settinger/12bitbadge/12bitbadge.kicad_pcb

## KiCad design 12bitbadge.kicad_pcb (2020-03-08)

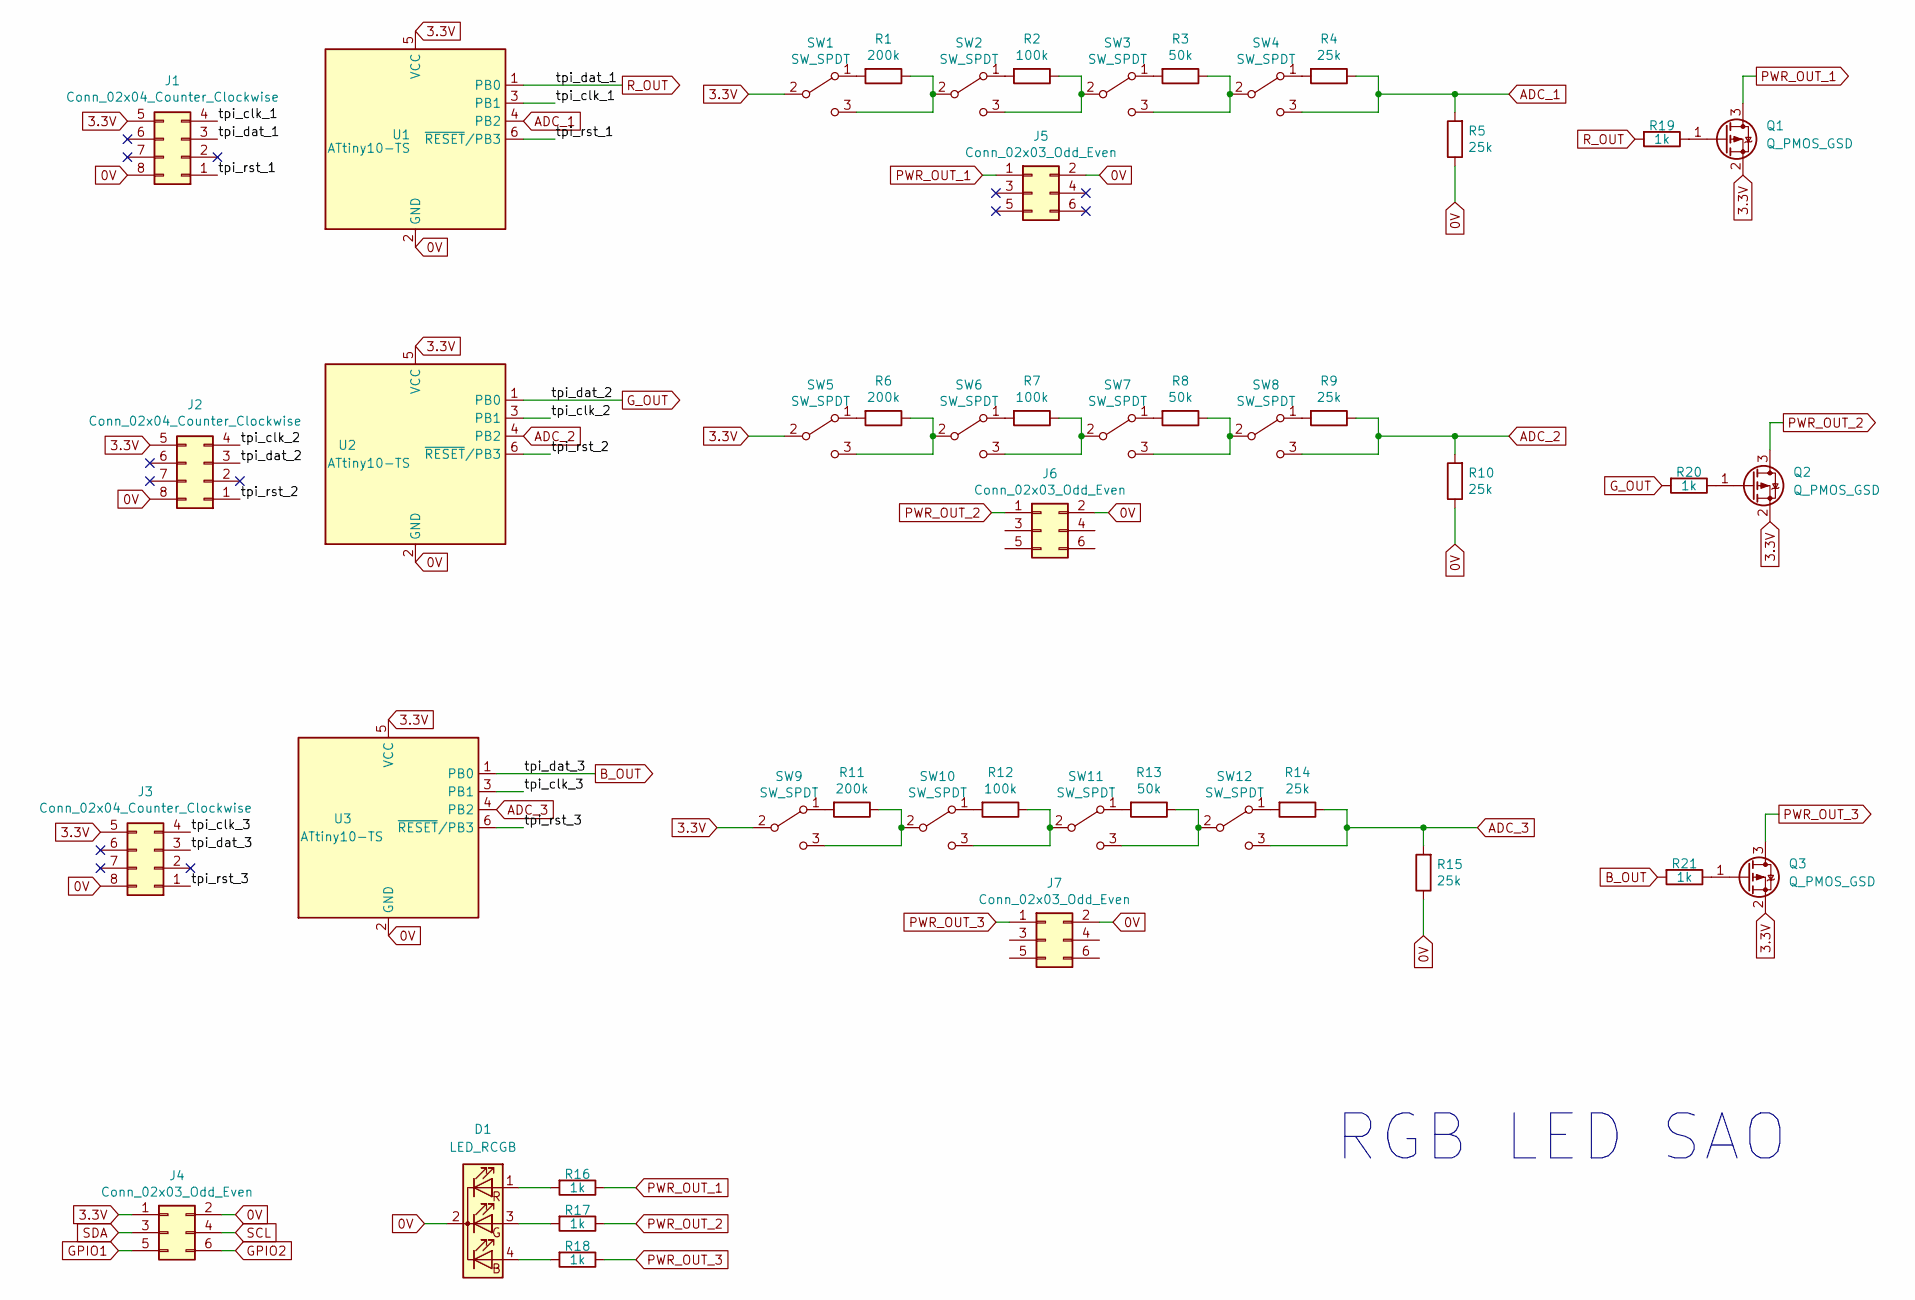
[picture p1: schematic 12bitbadge.sch]

Parts:
D1: LED_RCGB; LED_D5.0mm-4_RGB
J1, J2, J3: Conn_02x04_Counter_Clockwise; SOIC_clipProgSmall
J4: Conn_02x03_Odd_Even; PinHeader_2x03_P2.54mm_Vertical
J5, J6, J7: Conn_02x03_Odd_Even; PinSocket_2x03_P2.54mm_Vertical
Q1, Q2, Q3: Q_PMOS_GSD; SOT-23_Handsoldering
R1, R6, R11: 200k; R_0805_2012Metric_Pad1.15x1.40mm_HandSolder
R2, R7, R12: 100k; R_0805_2012Metric_Pad1.15x1.40mm_HandSolder
R3, R8, R13: 50k; R_0805_2012Metric_Pad1.15x1.40mm_HandSolder
R4, R5, R9, R10, R14, R15: 25k; R_0805_2012Metric_Pad1.15x1.40mm_HandSolder
R16, R17, R18, R19, R20, R21: 1k; R_0805_2012Metric_Pad1.15x1.40mm_HandSolder
SW1, SW2, SW3, SW4, SW5, SW6, SW7, SW8, SW9, SW10, SW11, SW12: SW_SPDT; SW_CuK_JS202011CQN_DPDT_Straight
U1, U2, U3: ATtiny10-TS; SOT-23-6_Handsoldering

Connections:
0V: D1.2 (K), J1.8, J2.8, J3.8, J4.2, J5.2, J6.2, J7.2, R5.1, R10.1, R15.1, U1.2 (GND), U2.2 (GND), U3.2 (GND)
3.3V: J1.5, J2.5, J3.5, J4.1, Q1.2 (S), Q2.2 (S), Q3.2 (S), SW1.2 (B), SW5.2 (B), SW9.2 (B), U1.5 (VCC), U2.5 (VCC), U3.5 (VCC)
/tpi_clk_1: J1.4, U1.3 (PB1)
/tpi_clk_2: J2.4, U2.3 (PB1)
/tpi_clk_3: J3.4, U3.3 (PB1)
/tpi_rst_1: J1.1, U1.6 (~RESET~/PB3)
/tpi_rst_2: J2.1, U2.6 (~RESET~/PB3)
/tpi_rst_3: J3.1, U3.6 (~RESET~/PB3)
ADC_1: R4.1, R5.2, SW4.3 (C), U1.4 (PB2)
ADC_2: R9.1, R10.2, SW8.3 (C), U2.4 (PB2)
ADC_3: R14.1, R15.2, SW12.3 (C), U3.4 (PB2)
B_OUT: J3.3, R21.2, U3.1 (PB0)
GPIO1: J4.5
GPIO2: J4.6
G_OUT: J2.3, R20.2, U2.1 (PB0)
unnamed: D1.1 (RA), R16.2
unnamed: D1.3 (GA), R17.2
unnamed: D1.4 (BA), R18.2
unnamed: Q1.1 (G), R19.1
unnamed: Q2.1 (G), R20.1
unnamed: Q3.1 (G), R21.1
unnamed: R1.1, SW1.3 (C), SW2.2 (B)
unnamed: R1.2, SW1.1 (A)
unnamed: R2.1, SW2.3 (C), SW3.2 (B)
unnamed: R2.2, SW2.1 (A)
unnamed: R3.1, SW3.3 (C), SW4.2 (B)
unnamed: R3.2, SW3.1 (A)
unnamed: R4.2, SW4.1 (A)
unnamed: R6.1, SW5.3 (C), SW6.2 (B)
unnamed: R6.2, SW5.1 (A)
unnamed: R7.1, SW6.3 (C), SW7.2 (B)
unnamed: R7.2, SW6.1 (A)
unnamed: R8.1, SW7.3 (C), SW8.2 (B)
unnamed: R8.2, SW7.1 (A)
unnamed: R9.2, SW8.1 (A)
unnamed: R11.1, SW9.3 (C), SW10.2 (B)
unnamed: R11.2, SW9.1 (A)
unnamed: R12.1, SW10.3 (C), SW11.2 (B)
unnamed: R12.2, SW10.1 (A)
unnamed: R13.1, SW11.3 (C), SW12.2 (B)
unnamed: R13.2, SW11.1 (A)
unnamed: R14.2, SW12.1 (A)
PWR_OUT_1: J5.1, Q1.3 (D), R16.1
PWR_OUT_2: J6.1, Q2.3 (D), R17.1
PWR_OUT_3: J7.1, Q3.3 (D), R18.1
R_OUT: J1.3, R19.2, U1.1 (PB0)
SCL: J4.4
SDA: J4.3

Notes on the sheet:
RGB LED SAO

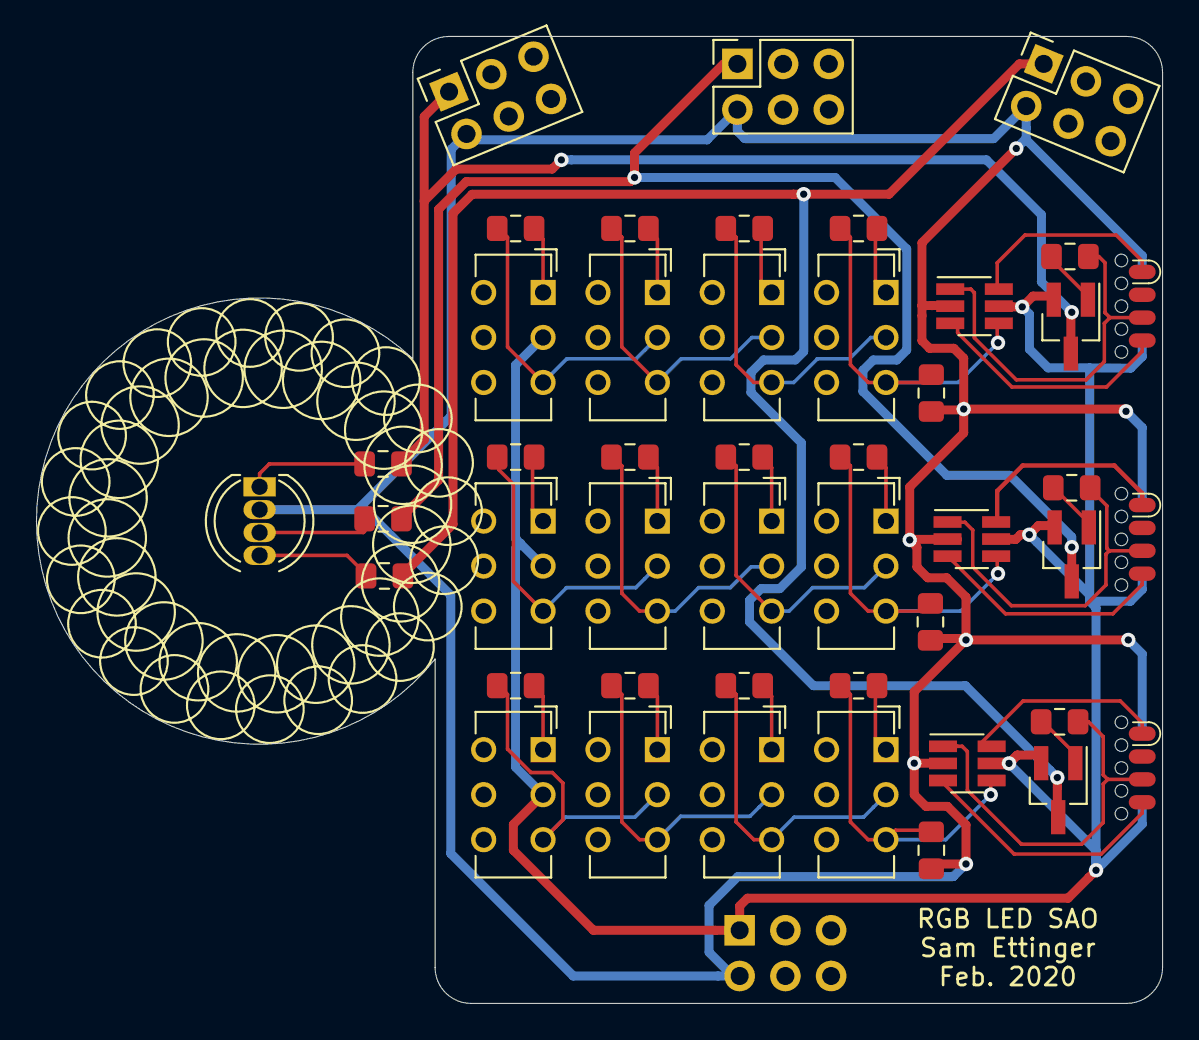
[picture p2: board 12bitbadge.kicad_pcb from above]

Board: 2 copper layers, 62.6 x 53.7 mm, 47 parts (1 on the bottom side), 44 nets.
