settinger/12bitbadge/(commit log)

2020-01-23 Initialized project
    [12bitbadge.kicad_pcb, 12bitbadge.sch]
2020-01-23 Small routing tweaks
    [12bitbadge.kicad_pcb]
2020-01-23 Removed errant trace above sheet
    [12bitbadge.kicad_pcb]
2020-01-23 Put the add-on add-onsat a more rakish angle
    [12bitbadge.kicad_pcb]
2020-01-23 Added gerbers
    [12bitbadge-B_Cu.gbr, 12bitbadge-B_Mask.gbr, 12bitbadge-B_Paste.gbr, 12bitbadge-B_SilkS.gbr, 12bitbadge-Edge_Cuts.gbr, 12bitbadge-F_Cu.gbr, 12bitbadge-F_Mask.gbr, 12bitbadge-F_Paste.gbr]
2020-01-25 Updated to hand-solderable SMD
    [12bitbadge-B_Cu.gbr, 12bitbadge-B_Mask.gbr, 12bitbadge-B_Paste.gbr, 12bitbadge-B_SilkS.gbr, 12bitbadge-Edge_Cuts.gbr, 12bitbadge-F_Cu.gbr, 12bitbadge-F_Mask.gbr, 12bitbadge-F_Paste.gbr]
2020-01-25 Added silkscreen rosettes
    [12bitbadge-B_Cu.gbr, 12bitbadge-B_Mask.gbr, 12bitbadge-B_Paste.gbr, 12bitbadge-B_SilkS.gbr, 12bitbadge-Edge_Cuts.gbr, 12bitbadge-F_Cu.gbr, 12bitbadge-F_Mask.gbr, 12bitbadge-F_Paste.gbr]
2020-01-26 Replaced switches with PWM-friendly MOSFETs
    [12bitbadge-B_Cu.gbr, 12bitbadge-B_Mask.gbr, 12bitbadge-B_Paste.gbr, 12bitbadge-B_SilkS.gbr, 12bitbadge-Edge_Cuts.gbr, 12bitbadge-F_Cu.gbr, 12bitbadge-F_Mask.gbr, 12bitbadge-F_Paste.gbr]
2020-01-26 Updated MOSFETs to hand-solderable pads
    [12bitbadge-B_Cu.gbr, 12bitbadge-B_Mask.gbr, 12bitbadge-B_Paste.gbr, 12bitbadge-B_SilkS.gbr, 12bitbadge-Edge_Cuts.gbr, 12bitbadge-F_Cu.gbr, 12bitbadge-F_Mask.gbr, 12bitbadge-F_Paste.gbr]
2020-01-26 Rounded the edges, which I always forget to do
    [12bitbadge-B_Cu.gbr, 12bitbadge-B_Mask.gbr, 12bitbadge-B_Paste.gbr, 12bitbadge-B_SilkS.gbr, 12bitbadge-Edge_Cuts.gbr, 12bitbadge-F_Cu.gbr, 12bitbadge-F_Mask.gbr, 12bitbadge-F_Paste.gbr]
2020-02-02 Removed copper pour, so Oshpark After Dark would look cooler
    [12bitbadge-B_Cu.gbr, 12bitbadge-B_Mask.gbr, 12bitbadge-B_Paste.gbr, 12bitbadge-B_SilkS.gbr, 12bitbadge-Edge_Cuts.gbr, 12bitbadge-F_Cu.gbr, 12bitbadge-F_Mask.gbr, 12bitbadge-F_Paste.gbr]
2020-02-19 Added some firmware, changed the order of the resistors to minimize ADC errors
    [12bitbadge.sch]
2020-03-08 Changed from common-anode RGB LED to common-cathode RGB LED
    [12bitbadge.kicad_pcb, 12bitbadge.sch]
